C-L1gh7/micro-hole-measurement/SingleChip/SingelChip/Core/Src/main.c

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
/* Includes ------------------------------------------------------------------*/
#include "main.h"

/* USER CODE BEGIN PD */
#define TIMEOUT_uS 10000           // 无通信超时时间（1秒）
/* USER CODE END PD */

TIM_HandleTypeDef htim2;

UART_HandleTypeDef huart1;

/* USER CODE BEGIN PV */
uint8_t rx_data;
/* USER CODE END PV */

void SystemClock_Config(void);
static void MX_GPIO_Init(void);
static void MX_USART1_UART_Init(void);
static void MX_TIM2_Init(void);
/* USER CODE BEGIN PFP */
void delay_us(uint32_t us);
void Motor_Run(uint32_t dir, uint32_t travel, uint32_t speed);
/* USER CODE END PFP */

/* USER CODE BEGIN 0 */

/* 延时函数 BEGIN ---------------------------------------------------------*/
void delay_us(uint32_t us)
{
	uint32_t differ = 0xffff-us-5;
	__HAL_TIM_SET_COUNTER(&htim2, differ);
	HAL_TIM_Base_Start(&htim2);
	
	while(differ < 0xffff-5)
	{
		differ = __HAL_TIM_GET_COUNTER(&htim2);
	}
	HAL_TIM_Base_Stop(&htim2);
}
/* 延时函数 END ---------------------------------------------------------*/
/* 电机转动函数 BEGIN ---------------------------------------------------------*/
void Motor_Run(uint32_t dir, uint32_t travel, uint32_t speed)
{
	switch (dir)
  {
  	case 1: //正转
			HAL_GPIO_WritePin(GPIOA, GPIO_PIN_3, GPIO_PIN_SET);
			HAL_GPIO_WritePin(GPIOA, GPIO_PIN_1, GPIO_PIN_SET);
  		break;
		case 2: //反转
			HAL_GPIO_WritePin(GPIOA, GPIO_PIN_3, GPIO_PIN_SET);
			HAL_GPIO_WritePin(GPIOA, GPIO_PIN_1, GPIO_PIN_RESET);
  		break;
  	default: //默认不转动
			HAL_GPIO_WritePin(GPIOA, GPIO_PIN_3, GPIO_PIN_RESET);
  		break;
  }
	//uint32_t pulse_num = (travel*64);
	for(uint32_t i=0; i<travel; i++)
	{
		GPIOA->ODR ^= GPIO_PIN_2;
		delay_us(speed);
	}
}
/* 电机转动函数 END ---------------------------------------------------------*/
void HAL_UART_RxCpltCallback(UART_HandleTypeDef *huart)
{
    if (huart->Instance == USART1)
    {
        switch (rx_data)
					{
						case '1':
								Motor_Run(1, 128, 30);
								HAL_UART_Transmit(&huart1, (uint8_t *)"D", 1, HAL_MAX_DELAY);
								break;

						case '2':
								Motor_Run(2, 128, 30);
								HAL_UART_Transmit(&huart1, (uint8_t *)"D", 1, HAL_MAX_DELAY);
								break;
						case '3':
								Motor_Run(1, 1280, 15);
								HAL_UART_Transmit(&huart1, (uint8_t *)"D", 1, HAL_MAX_DELAY);
								break;

						case '4':
								Motor_Run(2, 1280, 15);
								HAL_UART_Transmit(&huart1, (uint8_t *)"D", 1, HAL_MAX_DELAY);
								break;

						default:
								// 可选：未定义的指令
								break;
					}

        // 重新使能接收中断
        HAL_UART_Receive_IT(&huart1, &rx_data, 1);
    }
}
/* USER CODE END 0 */

/**
  * @brief  The application entry point.
  * @retval int
  */
int main(void)
{

  /* MCU Configuration--------------------------------------------------------*/

  /* Reset of all peripherals, Initializes the Flash interface and the Systick. */
  HAL_Init();

  /* Configure the system clock */
  SystemClock_Config();

  /* Initialize all configured peripherals */
  MX_GPIO_Init();
  MX_USART1_UART_Init();
  MX_TIM2_Init();
  /* Infinite loop */
  /* USER CODE BEGIN WHILE */
	HAL_UART_Receive_IT(&huart1, &rx_data, 1);
  while (1){
    /* USER CODE END WHILE */

    /* USER CODE BEGIN 3 */
  }
  /* USER CODE END 3 */
}

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
