C-L1gh7/micro-hole-measurement/SingleChip/SingelChip/SingelChip.ioc

Mcu.UserName=STM32F103C8Tx
PA1.Signal=GPIO_Output
PA10.Signal=USART1_RX
PA13.Signal=SYS_JTMS-SWDIO
PA14.Signal=SYS_JTCK-SWCLK
PA2.Signal=GPIO_Output
PA3.Signal=GPIO_Output
PA9.Signal=USART1_TX
PB12.Signal=GPIO_Input
PB13.Signal=GPIO_Input
PB14.Signal=GPIO_Input
PC13-TAMPER-RTC.Signal=GPIO_Output
