C-L1gh7/micro-hole-measurement/(commit log)

2025-05-04 添加了单片机微秒延时、电机驱动、usart1收发功能
2025-05-09 添加gitignore文件，添加main文件控制电机的代码
2025-05-09 优化自动裁切功能，完善边缘查找功能的可视化
2025-05-09 成了！一句话！单片机部分成了！但是行程的准确度有待改善
2025-05-12 纠正了步长和脉冲的对应关系，重新修正了防抖参数、添加了调试光路功能，引入了窗口不能实时更新的bug
2025-06-02 修正相机刷新被串口占用导致画面冻结的bug
2025-07-04 删减预处理步骤
2025-07-04 修改shot的截图逻辑，减少需要测算的像素数
2025-07-04 修改了高斯曲线拟合
2025-07-04 修正了高斯拟合
2025-07-04 把advan扔进lib里
2025-07-06 修改放大参数
2025-07-07 更新了一大堆
2025-07-07 改了一堆
2025-07-08 孩子们，会赢吗
2025-07-08 绝望了孩子
2025-07-08 Refactor focus analysis library and update main script
    - Enhanced the FocusAnalyzer class by removing the 'tenengrad' method and improving the focus calculation methods.
    - Added detailed docstrings for better understanding and maintenance.
    - Updated the analyze_folder method to handle image analysis more robustly.
    - Simplified the get_best_focus_images function for clarity and efficiency.
    - Modified the main.py script to use 'laplacian' method for focus analysis instead of 'tenengrad'.
    - Improved error handling and output formatting in the analysis summary and file saving functions.
    [main.c, main.py]
2025-07-09 更新聚焦度分析库，新增小波变换方法并调整主程序调用参数 孩子们，我好像成了
2025-07-10 更新聚焦度分析主程序，调整分析参数并优化输出结果格式 采用高斯偏态拟合优化孔深测量结果
2025-07-10 更新聚焦度分析和图像处理模块，重构函数参数，增强路径处理和错误提示
2025-07-17 更新聚焦度分析主程序，调整微信推送链接和时间格式，优化图片处理逻辑
2025-07-19 更新 README 文档，添加项目简介、环境要求、主要硬件、算法原理及注意事项；删除 CamAdjust.py 文件
2025-07-27 更新 README 文档，重构项目结构，添加系统架构、关键组件、工作原理及详细硬件设置步骤，优化入门指南和故障排除部分
2025-07-27 删除 README 文档中的目录标记
2025-07-27 更新 README 文档，添加详细目录结构以改善导航体验
2025-09-17 更新编译后的 Python 文件，确保与最新代码保持一致
2025-12-05 添加了matlab实现的方法，并再其中添加了修正函数
2025-12-15 feat: Implement focus analysis and visualization tools
    - Added a new MATLAB script `focus_analysis_main.m` for analyzing image focus and calculating depth information.
    - Introduced a new function `generate_figures.m` to create various visualizations including fitting curves, 3D models, and depth maps.
    - Modified `main.py` to switch camera input from 0 to 1 for improved compatibility.
    - Updated binary file `focus_analysis.cpython-38.pyc` to reflect changes in the focus analysis logic.
