C-L1gh7/micro-hole-measurement/(notices)

Notices in the files:
SingleChip/SingelChip/Core/Src/main.c:
Copyright (c) 2025 STMicroelectronics.
All rights reserved.
This software is licensed under terms that can be found in the LICENSE file
